kim-xps12/m5stack_board_unitree_brushless_digital_servo/m5stack_board_unitree_brushless_digital_servo.kicad_pcb

## KiCad design m5stack_board_unitree_brushless_digital_servo.kicad_pcb (2026-10-12)

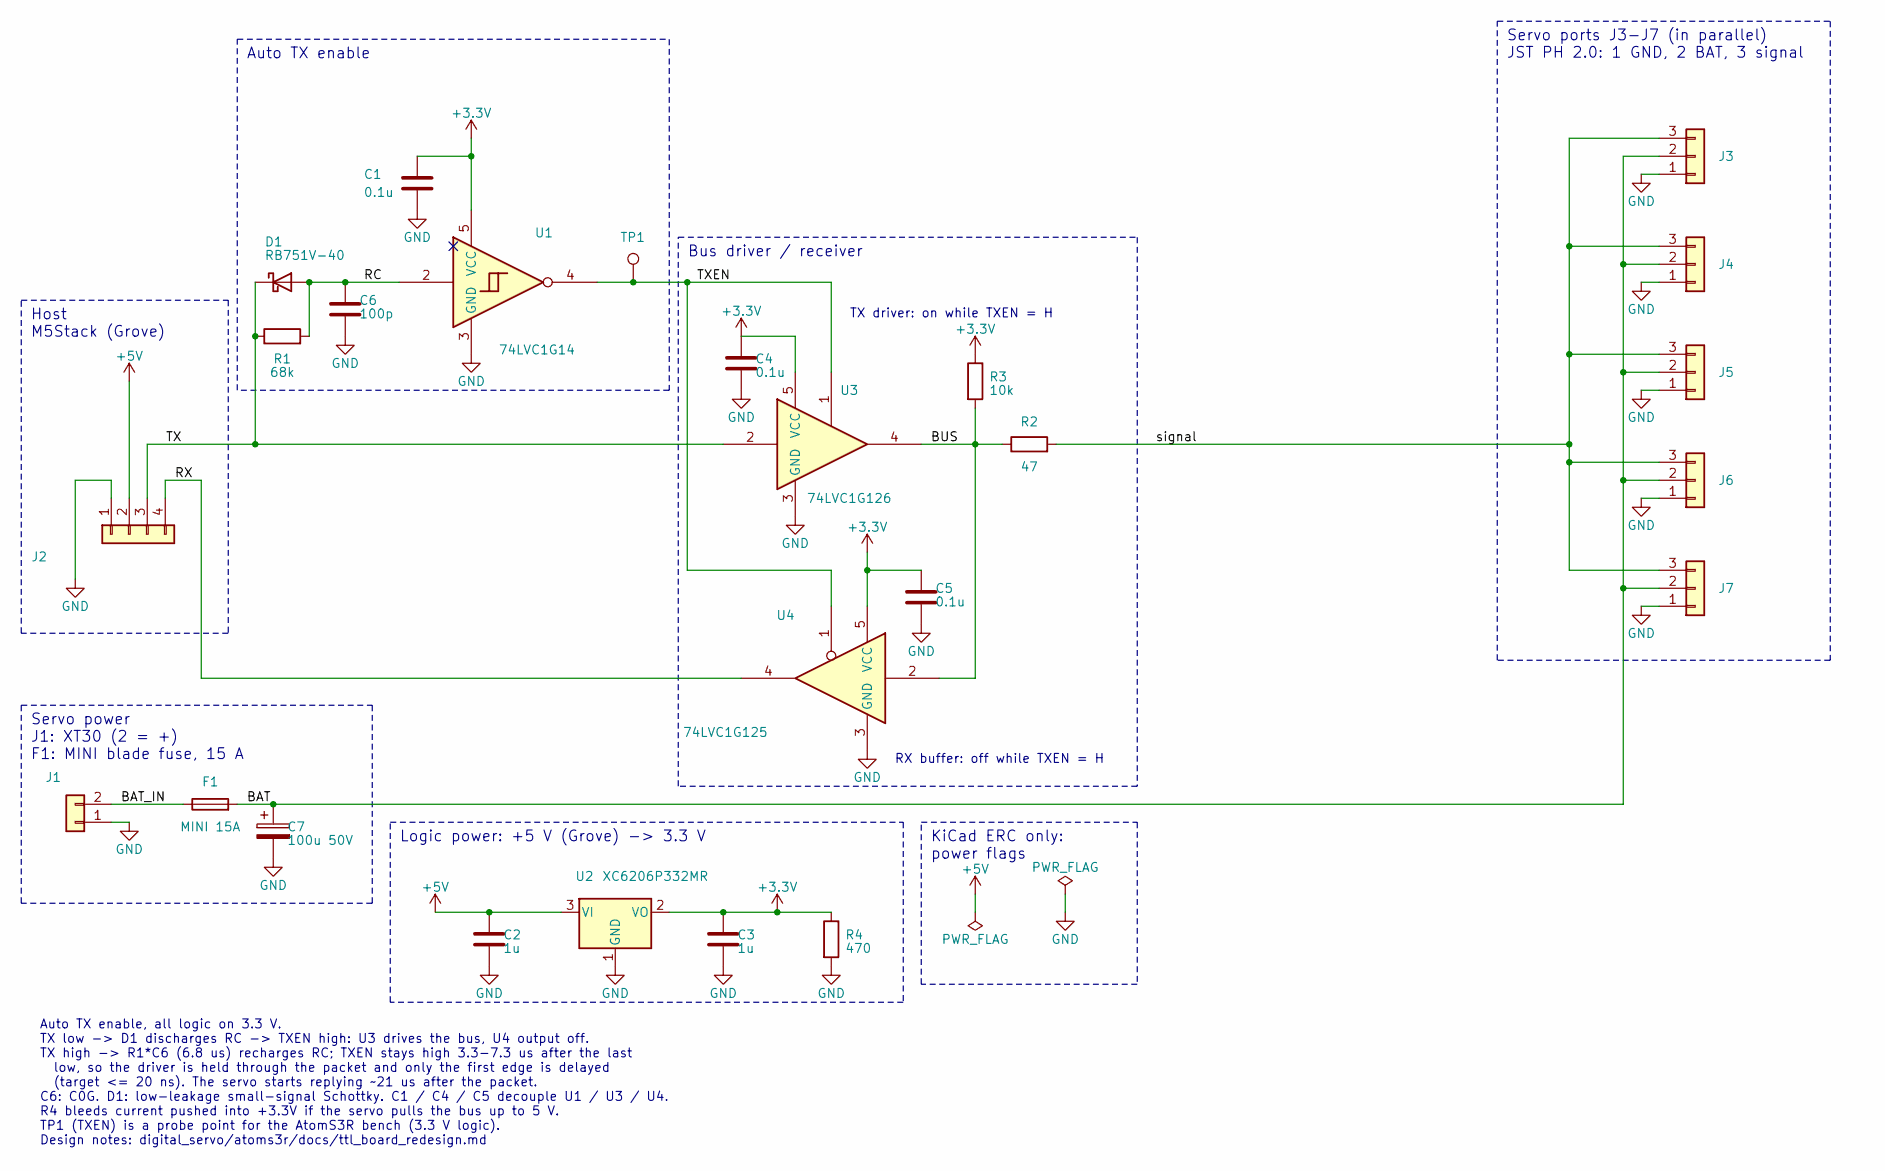
[picture p5: schematic m5stack_board_unitree_brushless_digital_servo.kicad_sch, Unitree Servo UART Board]

Parts:
C1, C4, C5: 0.1u; C_0603_1608Metric_Pad1.08x0.95mm_HandSolder; LCSC C14663
C2, C3: 1u; C_0603_1608Metric_Pad1.08x0.95mm_HandSolder; LCSC C15849
C6: 100p; C_0603_1608Metric_Pad1.08x0.95mm_HandSolder; LCSC C14858
C7: 100u 50V; CP_Elec_6.3x7.7; LCSC C3445238
D1: RB751V-40; D_SOD-323_HandSoldering; LCSC C7502691
F1: MINI 15A; Fuseholder_Blade_Mini_XFCN_XF-508P-B-B; LCSC C19727305
J1: XT30UPB-M; AMASS_XT30UPB-M_1x02_P5.0mm_Vertical; LCSC C428721
J2: ZX-HY2.0-4PZZ; HY2.0-4P_1x04_P2.00mm_Vertical; LCSC C7429580
J3, J4, J5, J6, J7: B3B-PH-K-S(LF)(SN); JST_PH_B3B-PH-K_1x03_P2.00mm_Vertical; LCSC C131339
R1: 68k; R_0603_1608Metric_Pad0.98x0.95mm_HandSolder; LCSC C23231
R2: 47; R_0603_1608Metric_Pad0.98x0.95mm_HandSolder; LCSC C23182
R3: 10k; R_0603_1608Metric_Pad0.98x0.95mm_HandSolder; LCSC C25804
R4: 470; R_0603_1608Metric_Pad0.98x0.95mm_HandSolder; LCSC C23179
TP1: TXEN; TestPoint_THTPad_D1.5mm_Drill0.7mm
U1: 74LVC1G14; SOT-23-5_HandSoldering; LCSC C7835
U2: XC6206P332MR; SOT-23; LCSC C5446
U3: 74LVC1G126; SOT-23-5_HandSoldering; LCSC C7834
U4: 74LVC1G125; SOT-23-5_HandSoldering; LCSC C23654

Connections:
+3.3V: C1.1, C3.1, C4.1, C5.1, R3.1, R4.1, U1.5 (VCC), U2.2 (VO), U3.5 (VCC), U4.5 (VCC)
+5V: C2.1, J2.2, U2.3 (VI)
/BAT: C7.1, F1.2, J3.2, J4.2, J5.2, J6.2, J7.2
/BAT_IN: F1.1, J1.2
/BUS: R2.1, R3.2, U3.4, U4.2
/RC: C6.1, D1.2 (A), R1.2, U1.2
/RX: J2.4, U4.4
/TX: D1.1 (K), J2.3, R1.1, U3.2
/TXEN: TP1.1, U1.4, U3.1, U4.1
/signal: J3.3, J4.3, J5.3, J6.3, J7.3, R2.2
GND: C1.2, C2.2, C3.2, C4.2, C5.2, C6.2, C7.2, J1.1, J2.1, J3.1, J4.1, J5.1, J6.1, J7.1, R4.2, U1.3 (GND), U2.1 (GND), U3.3 (GND), U4.3 (GND)

Notes on the sheet:
Host M5Stack (Grove)
Auto TX enable
TX driver: on while TXEN = H
Bus driver / receiver
RX buffer: off while TXEN = H
Servo ports J3-J7 (in parallel) JST PH 2.0: 1 GND, 2 BAT, 3 signal
Servo power J1: XT30 (2 = +) F1: MINI blade fuse, 15 A
Logic power: +5 V (Grove) -> 3.3 V
KiCad ERC only: power flags
Auto TX enable, all logic on 3.3 V. TX low -> D1 discharges RC -> TXEN high: U3 drives the bus, U4 output off. TX high -> R1*C6 (6.8 us) recharges RC; TXEN stays high 3.3-7.3 us after the last low, so the driver is held through the packet and only the first edge is delayed (target <= 20 ns). The se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

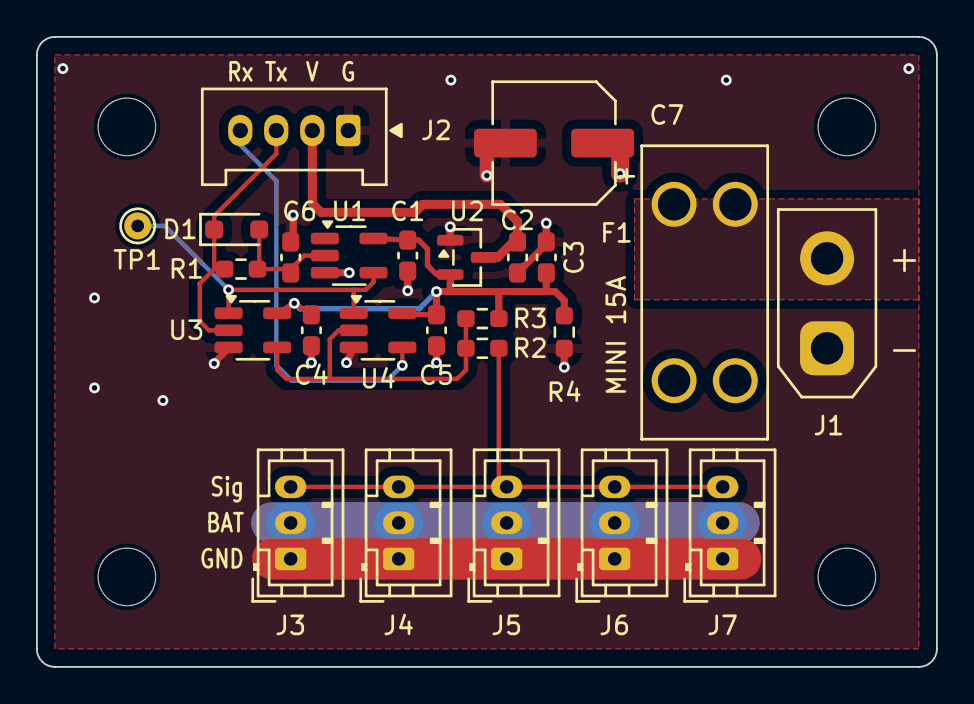
[picture p6: board m5stack_board_unitree_brushless_digital_servo.kicad_pcb from above]

Board: 2 copper layers, 50.0 x 35.0 mm, 29 parts (0 on the bottom side), 11 nets.

Other parts of the board:
MH1, MH2, MH3, MH4: MountingHole_3.2mm_M3
