kim-xps12/m5stack_board_unitree_brushless_digital_servo/(commit log)

2026-10-11 Add .gitignore and MIT license
    Ignore the JLCPCB order files (production/), the EasyEDA 3D models (Library.3dshapes/), and KiCad lock, cache, per-user settings and backup files.
    Claude-Session: https://claude.ai/code/session_01WJ1YBGdXpG8xhBv94Snq4Y
2026-10-11 Add the project footprint library
    Library.pretty is registered as "Library" in fp-lib-table.
    - HY2.0-4P (J2, Megastar ZX-HY2.0-4PZZ) and XT30UPB-M (J1); their 3D models
    come from EasyEDA and are fetched separately (see README).
    - Copies of the KiCad library footprints used on the board, with the
    silkscreen widened to 0.15 mm (JLCPCB minimum) and the JST PH pads widened
    to 1.25 mm (0.25 mm annular ring).
    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
2026-10-11 Add the KiCad project: schematic, PCB and JLCPCB design rules
    M5Stack (Grove) to Unitree J288 / S288 servo bus board, 50 x 35 mm, 2 layers.
    - Auto TX enable (D1 / R1 / C6 + 74LVC1G14) switching a 74LVC1G126 bus driver
    and a 74LVC1G125 receiver; all logic on 3.3 V (AP7333 from the Grove 5 V).
    - Servo supply from an XT30UPB (J1) with a 100 uF bulk capacitor, five JST PH
    ports (J3-J7, 1 GND, 2 BAT, 3 signal, as on the servo).
    - Every part has an LCSC number for JLCPCB assembly; the DRC rule file holds
    JLCPCB's recommended values (2 layers, 1 oz). ERC and DRC are clean.
    Claude-Session: https://claude.ai/code/session_01WJ1YBGdXpG8xhB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
    [m5stack_board_unitree_brushless_digital_servo.kicad_pcb, m5stack_board_unitree_brushless_digital_servo.kicad_sch]
2026-10-11 Add the JLCPCB order file export script
    tools/jlcpcb_export.py (run with KiCad's Python) writes the Gerber/drill zip, the BOM and the CPL to production/, with the rotation and origin corrections for the JLCPCB land patterns.
    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
2026-10-11 Add README and board images
    Overview, pin assignment, specifications, BOM, JLCPCB ordering and 3D model notes, with 3D views, the schematic and a dimension drawing in docs/.
    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
2026-10-11 Keep GND vias out of other nets' pour clearance; fix the pour clearance at 0.5 mm
    GND vias whose copper reached into the 0.5 mm pour clearance of another net's
    track showed as bulges in the pour edge.
    - C6 GND via 0.14 mm right (x 144.24): >= 0.5 mm from RX (B.Cu) and +5V (F.Cu).
    - U4 GND via 0.2 mm right (x 147.20), clear of the BUS track on F.Cu.
    - +3.3V on B.Cu lowered 0.3 mm (y 125.10), clear of the C1 GND via.
    - RX on B.Cu lowered 0.1 mm (y 129.10), clear of the C4 / U4 GND vias.
    The JLCPCB clearance rule (0.15 mm) also set the pour clearance, so a refill
    in KiCad shrank it from the zones' 0.5 mm to 0.15 mm. A rule for zones keeps
    0.5 mm; the zones are refilled with it. DRC (with sche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
    [m5stack_board_unitree_brushless_digital_servo.kicad_pcb]
2026-10-11 Save the project file in the KiCad 9 format; ignore work/
    KiCad rewrites the project file in its current format whenever the project is
    opened; this is that rewrite (format version, defaults, and the file name left
    over from the generator). No setting changes.
    work/ holds local working files (archived generator scripts, board checks,
    data downloaded from EasyEDA) and stays out of the repository.
    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
2026-10-11 Update the README 3D views
    The oblique view is now tilted 30 degrees from the top (was 55-60), so the
    silkscreen reads naturally and is no longer hidden behind C7. The top view
    shows the moved GND vias.
    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
2026-10-11 Add the board check and image scripts
    - tools/check_all.sh runs DRC (with schematic parity), ERC, the checks below,
    the JLCPCB export and, when work/jlc/ exists, the CPL check.
    - tools/checks/: fillcheck (saved zone fills match a fresh refill), viacheck
    (GND vias bulging into other nets' pour clearance) and holecheck (only GND
    copper within 3.5 mm of the mounting holes).
    - tools/render_images.sh writes the screenshots and the README images to
    production/images/, and with --readme copies the changed ones to docs/.
    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
2026-10-11 Support 4 Mbps only; tell users to set the servos to 4 Mbps first
    The README said 6 Mbps by default, but the TX enable timing was designed and
    measured at 4 Mbps. The board now handles 4 Mbps only, and the README asks
    users to change the servos' baud rate to 4 Mbps with the official Unitree
    tool before use.
    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
2026-10-11 Use a Preferred Extended RB751V-40 for D1
    D1 moves from the Nexperia RB751V40,115 (C553814, Extended) to the
    hongjiacheng RB751V-40 (C7502691, Preferred Extended), which carries no
    feeder loading fee in Economic PCBA and has more stock. The ratings match
    (VF <= 0.37 V at 1 mA, IR <= 0.5 uA at 30 V, 2 pF), and the footprint is the
    same.
    Its JLCPCB land pattern has the cathode as pin 1 on the left, as in KiCad,
    so the CPL needs no rotation (the old part had the anode as pin 1, +180).
    The CPL check puts its pads within 0.11 mm of the board pads.
    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
    [m5stack_board_unitree_brushless_digital_servo.kicad_pcb, m5stack_board_unitree_brushless_digital_servo.kicad_sch]
2026-10-11 Allow land pattern differences up to 0.4 mm in the CPL check
    JLCPCB land patterns can sit up to about 0.3 mm from the KiCad pads (longer
    hand-soldering pads, a wider SOT-23 lead span) while the part centre still
    matches. A wrong rotation or origin moves the pads by a pin pitch (0.9 mm or
    more), so 0.4 mm still catches those.
    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
2026-10-11 Use the Basic part XC6206P332MR for U2
    U2 was the AP7333-33SAG carried over from the DYNAMIXEL board: an Extended
    part with the lowest stock in the BOM (about 16k). The Torex XC6206P332MR-G
    (C5446) is a Basic part (no feeder loading fee in Economic PCBA, about 420k
    in stock) and covers the few mA the logic draws (200 mA, 6 V input, stable
    with the 1 uF C2 and C3).
    Its pins differ (1 GND, 2 output, 3 input), so:
    - the schematic uses the KiCad XC6206PxxxMR symbol (same pin positions);
    - on the board, C2 + feeds pin 3, pin 1 gets a GND via above it, the +5V
    line above U2 moves up 0.45 mm to keep that via clear of its pour
    clearance, and C2 - now joins C3 -;
    - the CPL keeps +180 (same land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
    [m5stack_board_unitree_brushless_digital_servo.kicad_pcb, m5stack_board_unitree_brushless_digital_servo.kicad_sch]
2026-10-11 Check the pin assignment of every part against the specification
    tools/checks/pincheck.py compares every pin of every part, in the
    schematic (netlist) and on the board (pads), with a table written from the
    specification and the datasheets: the net, the pin function where the symbol
    names it, the LCSC number, and the silkscreen next to the connectors ("Rx Tx
    V G", "+" / "-", "Sig / BAT / GND"). check_all.sh runs it.
    Swapping U2 pins 1 and 3, J2 TX and RX, D1, C7 or a port's pins 1 and 3, a
    wrong LCSC number, a misplaced "Rx" label, or the old U2 symbol in the
    schematic all fail the check.
    Claude-Session: https://claude.ai/code/session_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
2026-10-12 Add the servo power fuse and pre-order fixes (ordered as 062722a) (#1)
    * Add a MINI blade fuse F1 between J1 and BAT
    BAT had no protection: a short on the board or in the servo wiring would let
    the battery drive a large current with nothing to break it. F1 takes a MINI
    blade fuse (ISO 8820-3, 32 V, 1000 A breaking capacity), which car parts shops
    in Japan sell; the fuse itself is user supplied. 15 A covers five J288 servos
    (9.6 A worst case) and stays within the XT30 rating.
    - Footprint: two Keystone 3557 universal clips (LCSC C2680614, wave soldered
    in Economic PCBA) 9.73 mm apart, per the Keystone layout for MINI fuses,
    bodies facing each other; pads fully connected to the pours.
    - S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
    [m5stack_board_unitree_brushless_digital_servo.kicad_pcb, m5stack_board_unitree_brushless_digital_servo.kicad_sch]
2026-10-21 Record the prototype test results in docs/design.md (#2)
    The JLCPCB board (062722a) was tested with an AtomS3R, an S288 and a J288
    (both set to 4 Mbps) on a 7.5 V servo supply:
    - Bench, no servo, G5 on the bus and on TP1: first-edge delay 12.5 ns (one
    capture tick, target 20 ns or less); TXEN holds for 5.4-5.9 us after the
    last rising edge (design 3.27-7.30 us) and stays on through whole 4 Mbps
    packets.
    - Both servos: 100,000 exchanges per command pattern with no error, and
    14,000 sine-swing cycles each at exactly 4,000,000 bps without a miss.
    - Tolerance window -3.03..+0.31 % for both servos and both command
    patterns, so the data dependence of the old board is gone; its upper
    e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
2026-11-02 Link the design notes under m5stack_playground_unitree_servo (#6)
    The experiment repository holding atoms3r/docs/ttl_board_redesign.md
    was renamed from m5stack_example_unitree_servo to
    m5stack_playground_unitree_servo, and the old name now belongs to a
    separate swing sample. GitHub no longer redirects the old links, so
    they would land in the sample and miss the design notes.
